Professor-plum/Bsides-SLC-2021/README.md

# Bsides-SLC-2021
Bsides SLC 2021 Badge repository
