Professor-plum/Bsides-SLC-2021/hardware/BSidesSLC2021/BSidesSLC2021.html

# /Users/waylongrange/Documents/BSidesSLC2021/BSidesSLC2021.sch

Tuesday, September 07, 2021 at 08:30:32 AM

Eeschema (5.1.10-1-10_14)

Component Count:44

Ref | Qnty | Value | Part | Datasheet | Description | Vendor
BT1 | 1 | Battery_Cell | Device:Battery_Cell | ~ | Single-cell battery
C1, C2, C7, C8, C9 | 5 | 1uf | Device:C | ~ | Unpolarized capacitor
C3, C4, C5 | 3 | .1uf | Device:C | ~ | Unpolarized capacitor
C6 | 1 | 10uf | Device:C | ~ | Unpolarized capacitor
C10 | 1 | 4.7uf | Device:C | ~ | Unpolarized capacitor
C11 | 1 | 2.2uf | Device:C | ~ | Unpolarized capacitor
D1, D2, D3, D4, D5, D6, D7, D8, D9, D10, D11, D12 | 12 | LED | Device:LED | ~ | Light emitting diode
D13 | 1 | LD271 | LED:LD271 | http://www.alliedelec.com/m/d/40788c34903a719969df15f1fbea1056.pdf | 940nm IR-LED, 5mm
J1 | 1 | Conn_PIC_ICSP_ICD | Connector:Conn_PIC_ICSP_ICD | http://ww1.microchip.com/downloads/en/devicedoc/30277d.pdf | Microchip PIC In-Circuit Serial Programming/Debugging (ICSP/ICD) connector
JP1 | 1 | Jumper_2_Open | Jumper:Jumper_2_Open | ~ | Jumper, 2-pole, open
R1 | 1 | 5K | Device:R_US | ~ | Resistor, US symbol
R2, R3, R6 | 3 | 10K | Device:R_US | ~ | Resistor, US symbol
R4, R7 | 2 | 910K | Device:R_US | ~ | Resistor, US symbol
R5 | 1 | 1K | Device:R_US | ~ | Resistor, US symbol
RV1, RV2 | 2 | R_POT_US | Device:R_POT_US | ~ | Potentiometer, US symbol
SW1, SW2 | 2 | SW_Push | Switch:SW_Push | ~ | Push button switch, generic, two pins
U1 | 1 | MC3419 | Kicad_Grange:MC3419
U2 | 1 | LP5012 | Kicad_Grange:LP5012
U3 | 1 | PIC16LF18346-xGZ | MCU_Microchip_PIC16:PIC16LF18346-xGZ | https://ww1.microchip.com/downloads/en/DeviceDoc/40001839E.pdf | 28KB FLASH, 2KB SRAM, 256B EEPROM, QFN-20
U4 | 1 | TSOP17xx | Interface_Optical:TSOP17xx | http://www.micropik.com/PDF/tsop17xx.pdf | Photo Modules for PCM Remote Control Systems
U5 | 1 | 74LVC1G00 | 74xGxx:74LVC1G00 | http://www.ti.com/lit/sg/scyt129e/scyt129e.pdf | Single NAND Gate, Low-Voltage CMOS
U6 | 1 | OLED_128x64 | Kicad_Grange:OLED_128x64
