Professor-plum/Bsides-SLC-2021/hardware/BSidesSLC2021/BSidesSLC2021.xlsx

BSidesSLC2021
Reference | Quantity | Value | Footprint | Datasheet | MANUFACTURER | PARTNUMBER | MAXIMUM_PACKAGE_HEIGHT | PARTREV | STANDARD
BT1 | 1 | Battery_Cell | Battery:BatteryHolder_Keystone_3034_1x20mm | https://www.mouser.com/datasheet/2/215/3034-743109.pdf | Keystone | 3034
C10 | 1 | 2.2uf | Capacitor_SMD:C_0603_1608Metric_Pad1.08x0.95mm_HandSolder | ~ | Taiyo Yuden | JMK107BJ225KAHT
C11 | 1 | 4.7uf | Capacitor_SMD:C_0603_1608Metric_Pad1.08x0.95mm_HandSolder | ~ | Samsung | CL10A475KP8NNNC
C3 C4 C5 | 3 | .1uf | Capacitor_SMD:C_0603_1608Metric_Pad1.08x0.95mm_HandSolder | ~ | TDK | C0603X6S0J104K030BC
C6 | 1 | 10uf | Capacitor_SMD:C_0603_1608Metric_Pad1.08x0.95mm_HandSolder | ~ | Samsung | CL10A106KQ8NNNC
C1 C2 C7 C8 C9 | 5 | 1uf | Capacitor_SMD:C_0603_1608Metric_Pad1.08x0.95mm_HandSolder | ~ | Kemet | C0603C105K9PACTU
D1 D2 D3 D4 D5 D6 D7 D8 D9 D10 D11 D12 | 12 | White | LED_SMD:LED_0603_1608Metric | ~ | Inolux | IN-S63AT5UW
D13 | 1 | VSMB10940 | DIO_VSMB10940 | https://www.mouser.com/datasheet/2/427/VISH_S_A0001109401_1-2566942.pdf | VISHAY | VSMB10940 | 1.00mm | 1.1 | Manufacturer Recommendations
R1 | 1 | 10K | Resistor_SMD:R_0603_1608Metric | ~ | Yageo | AC0603FR-0710KL
R2 R3 R6 | 3 | 4.7K | Resistor_SMD:R_0603_1608Metric | ~ | VISHAY | CRCW06034K70JNEAC
R5 | 1 | 1K | Resistor_SMD:R_0603_1608Metric | ~ | Yageo | RC0603FR-071KL
R4 R7 | 2 | 910K | Resistor_SMD:R_0603_1608Metric | ~ | Yageo | RC0603FR-07910KL
RV1 RV2 | 2 | R_POT_US | Potentiometer_THT:Potentiometer_Bourns_PTV09A-1_Single_Vertical | https://www.mouser.com/datasheet/2/54/ptv09-777818.pdf | Bourns | PTV09A-4015U-B503
SW1 SW2 | 2 | SW_Push | Button_Switch_SMD:SW_SPST_PTS645 | https://www.mouser.com/datasheet/2/60/pts645-1841767.pdf | C&K | PTS645SK50SMTR92LFS
U1 | 1 | MC3419 | Package_LGA:LGA-12_2x2mm_P0.5mm | https://www.mouser.com/datasheet/2/821/MEMSIC_MC3419_Datasheet-1889799.pdf | MEMSIC | MC3419
U2 | 1 | LP5012 | Package_SO:TSSOP-24_4.4x7.8mm_P0.65mm | https://www.ti.com/lit/gpn/lp5012 | TI | LP5012
U3 | 1 | PIC16LF18346-xGZ | Package_SO:SSOP-20_5.3x7.2mm_P0.65mm | https://ww1.microchip.com/downloads/en/DeviceDoc/40001839E.pdf | Microchip | PIC16LF18346-I/SS
U4 | 1 | TSOP39xx | Grange:TSOP392TR1 | https://www.vishay.com/docs/82788/tsop392tr1.pdf | VISHAY | TSOP39438TR1
U5 | 1 | 74LVC1G00 | Package_TO_SOT_SMD:SOT-353_SC-70-5 | https://www.diodes.com/assets/Datasheets/74LVC1G00.pdf | Diodes Incorporated | 74LVC1G00SE-7
U6 | 1 | OLED_128x64 Blue & Yellow | Grange:SSD1306_ribbon | https://www.vishay.com/docs/37902/oled128o064dbpp3n00000.pdf |  | https://www.alibaba.com/product-detail/0-96-Oled-0-96-Small_1600229512123.html
