Professor-plum/Bsides-SLC-2021/hardware/BSidesSLC2021/BSidesSLC2021.pdf

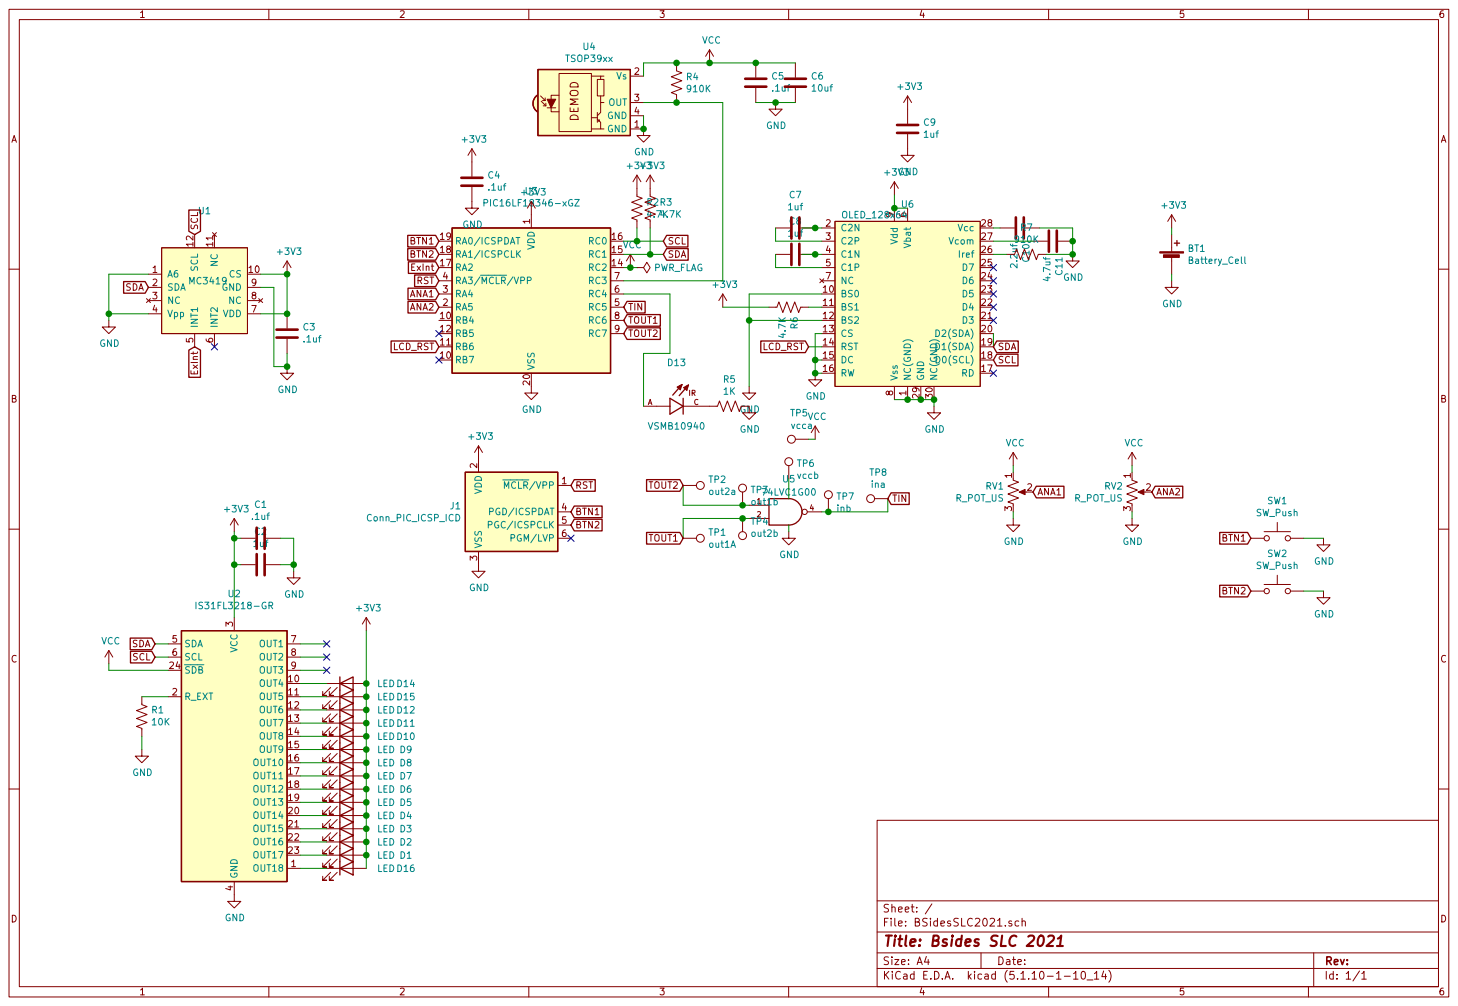
[picture p1: page 1]

1 RB4 10 RB7 10 RB6 11 RB5 12 RC2 14 RC1 15 RC0 16 RA2 17 RA1/ICSPCLK 18 RA0/ICSPDAT 19 RA5 2 VSS 20 RA4 3 RA3/MCLR/VPP 4 RC5 5 RC4 6 RC3 7 RC6 8 RC7 9 U3 PIC16LF18346-xGZ

6 VDD 7 NC 8 GND 9 U1 MC3419 GND

3 RV2 R_POT_US SW1 SW_Push SW2 SW_Push NC(GND) 1 BS0 10 BS1 11 BS2 12 CS 13 RST 14 DC 15 RW 16 RD 17 D0(SCL) 18 D1(SDA) 19 C2N 2 D2(SDA) 20 D3 21 D4 22 D5 23 D6 24 D7 25

File: BSidesSLC2021.sch Sheet: / VDD

3 PGD/ICSPDAT 4 PGC/ICSPCLK 5 PGM/LVP 6

Id: 1/1 Title: Bsides SLC 2021
