Professor-plum/Bsides-SLC-2021/hardware/BSidesSLC2021/BSidesSLC2021.kicad_pcb

## KiCad design hardware/BSidesSLC2021/BSidesSLC2021.kicad_pcb (2021-11-02)

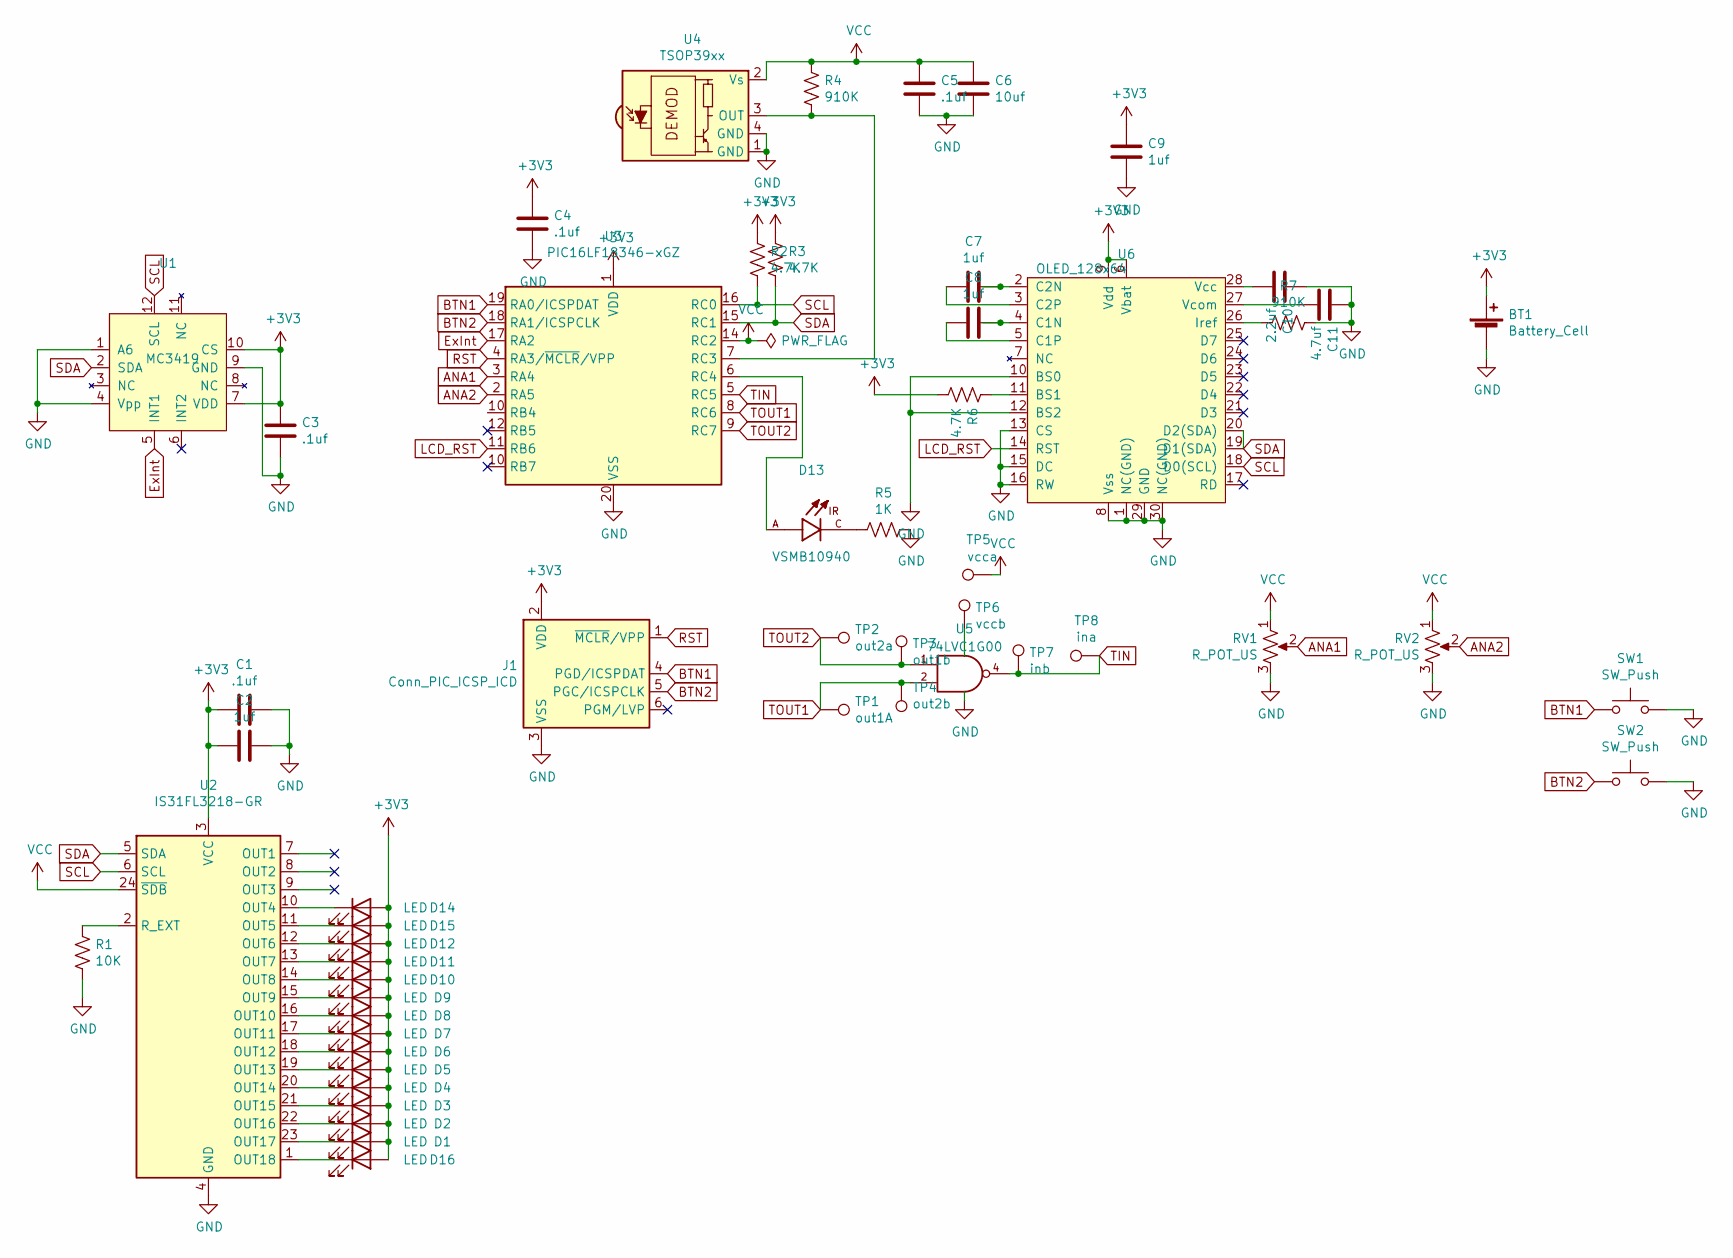
[picture p2: schematic BSidesSLC2021.sch, Bsides SLC 2021]

Parts:
BT1: Battery_Cell; BatteryHolder_Keystone_3034_1x20mm
C1, C3, C4, C5: .1uf; C_0603_1608Metric_Pad1.08x0.95mm_HandSolder
C2, C7, C8, C9: 1uf; C_0603_1608Metric_Pad1.08x0.95mm_HandSolder
C6: 10uf; C_0603_1608Metric_Pad1.08x0.95mm_HandSolder
C10: 2.2uf; C_0603_1608Metric_Pad1.08x0.95mm_HandSolder
C11: 4.7uf; C_0603_1608Metric_Pad1.08x0.95mm_HandSolder
D1, D2, D3, D4, D5, D6, D7, D8, D9, D10, D11, D12, D14, D15, D16: LED; LED_0603_1608Metric
D13: VSMB10940; DIO_VSMB10940; PARTREV 1.1
J1: Conn_PIC_ICSP_ICD; Batt_Conn5
R1: 10K; R_0603_1608Metric
R2, R3, R6: 4.7K; R_0603_1608Metric
R4, R7: 910K; R_0603_1608Metric
R5: 1K; R_0603_1608Metric
RV1, RV2: R_POT_US; Potentiometer_Bourns_PTV09A-1_Single_Vertical
SW1, SW2: SW_Push; SW_SPST_PTS645
TP1: out1A; TestPoint_Pad_D1.0mm
TP2: out2a; TestPoint_Pad_D1.0mm
TP3: out1b; TestPoint_Pad_D1.0mm
TP4: out2b; TestPoint_Pad_D1.0mm
TP5: vcca; TestPoint_Pad_D1.0mm
TP6: vccb; TestPoint_Pad_D1.0mm
TP7: inb; TestPoint_Pad_D1.0mm
TP8: ina; TestPoint_Pad_D1.0mm
U1: MC3419; LGA-12_2x2mm_P0.5mm
U2: IS31FL3218-GR; SOP-24_7.5x15.4mm_P1.27mm
U3: PIC16LF18346-xGZ; SSOP-20_5.3x7.2mm_P0.65mm
U4: TSOP39xx; TSOP392TR1
U5: 74LVC1G00; SOT-353_SC-70-5
U6: OLED_128x64; SSD1306_ribbon

Connections:
+3V3: BT1.1 (+), C1.1, C2.2, C3.2, C4.2, C9.2, D1.2 (A), D2.2 (A), D3.2 (A), D4.2 (A), D5.2 (A), D6.2 (A), D7.2 (A), D8.2 (A), D9.2 (A), D10.2 (A), D11.2 (A), D12.2 (A), D14.2 (A), D15.2 (A), D16.2 (A), J1.2 (VDD), R2.1, R3.1, R6.2, U1.7 (VDD), U1.10 (CS), U2.3 (VCC), U3.1 (VDD), U6.6 (Vbat), U6.9 (Vdd)
ANA1: RV1.2, U3.3 (RA4)
ANA2: RV2.2, U3.2 (RA5)
BTN1: J1.4 (PGD/ICSPDAT), SW1.1, U3.19 (RA0/ICSPDAT)
BTN2: J1.5 (PGC/ICSPCLK), SW2.1, U3.18 (RA1/ICSPCLK)
ExInt: U1.5 (INT1), U3.17 (RA2)
GND: BT1.2 (-), C1.2, C2.1, C3.1, C4.1, C5.1, C6.1, C9.1, C10.2, C11.2, J1.3 (VSS), R1.1, R5.1, R7.1, RV1.3, RV2.3, SW1.2, SW2.2, U1.1 (A6), U1.4 (Vpp), U1.9 (GND), U2.4 (GND), U3.20 (VSS), U4.1 (GND), U4.4 (GND), U5.3 (GND), U6.1 (NC(GND)), U6.8 (Vss), U6.10 (BS0), U6.12 (BS2), U6.13 (CS), U6.15 (DC), U6.16 (RW), U6.29 (GND), U6.30 (NC(GND))
LCD_RST: U3.11 (RB6), U6.14 (RST)
unnamed: C7.1, U6.2 (C2N)
unnamed: C7.2, U6.3 (C2P)
unnamed: C8.1, U6.4 (C1N)
unnamed: C8.2, U6.5 (C1P)
unnamed: C10.1, U6.28 (Vcc)
unnamed: C11.1, U6.27 (Vcom)
unnamed: D1.1 (K), U2.23 (OUT17)
unnamed: D2.1 (K), U2.22 (OUT16)
unnamed: D3.1 (K), U2.21 (OUT15)
unnamed: D4.1 (K), U2.20 (OUT14)
unnamed: D5.1 (K), U2.19 (OUT13)
unnamed: D6.1 (K), U2.18 (OUT12)
unnamed: D7.1 (K), U2.17 (OUT11)
unnamed: D8.1 (K), U2.16 (OUT10)
unnamed: D9.1 (K), U2.15 (OUT9)
unnamed: D10.1 (K), U2.14 (OUT8)
unnamed: D11.1 (K), U2.13 (OUT7)
unnamed: D12.1 (K), U2.12 (OUT6)
unnamed: D13.A, U3.6 (RC4)
unnamed: D13.C, R5.2
unnamed: D14.1 (K), U2.10 (OUT4)
unnamed: D15.1 (K), U2.11 (OUT5)
unnamed: D16.1 (K), U2.1 (OUT18)
unnamed: R1.2, U2.2 (R_EXT)
unnamed: R4.2, U3.7 (RC3), U4.3 (OUT)
unnamed: R6.1, U6.11 (BS1)
unnamed: R7.2, U6.26 (Iref)
RST: J1.1 (~MCLR~/VPP), U3.4 (RA3/~MCLR~/VPP)
SCL: R2.2, U1.12 (SCL), U2.6 (SCL), U3.16 (RC0), U6.18 (D0(SCL))
SDA: R3.2, U1.2 (SDA), U2.5 (SDA), U3.15 (RC1), U6.19 (D1(SDA)), U6.20 (D2(SDA))
TIN: TP7.1, TP8.1, U3.5 (RC5), U5.4
TOUT1: TP1.1, TP4.1, U3.8 (RC6), U5.2
TOUT2: TP2.1, TP3.1, U3.9 (RC7), U5.1

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
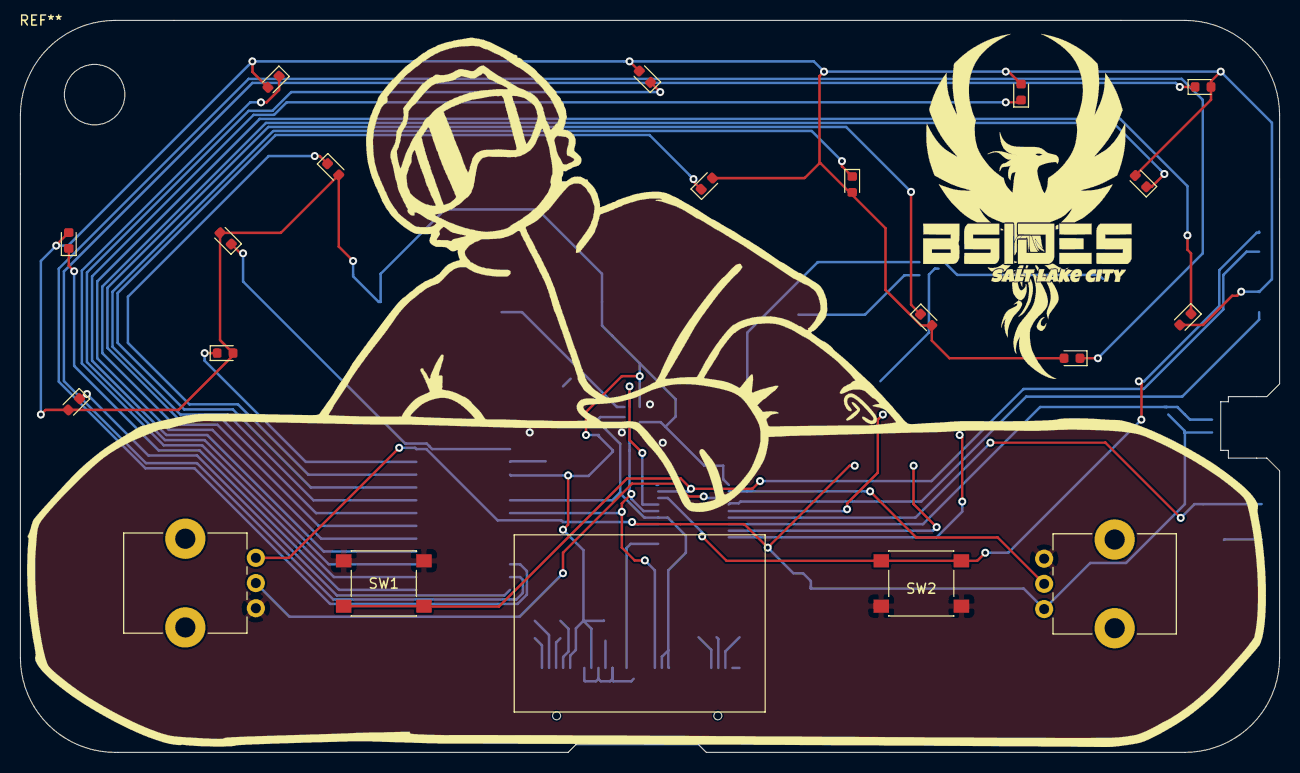
[picture p3: board BSidesSLC2021.kicad_pcb from above]

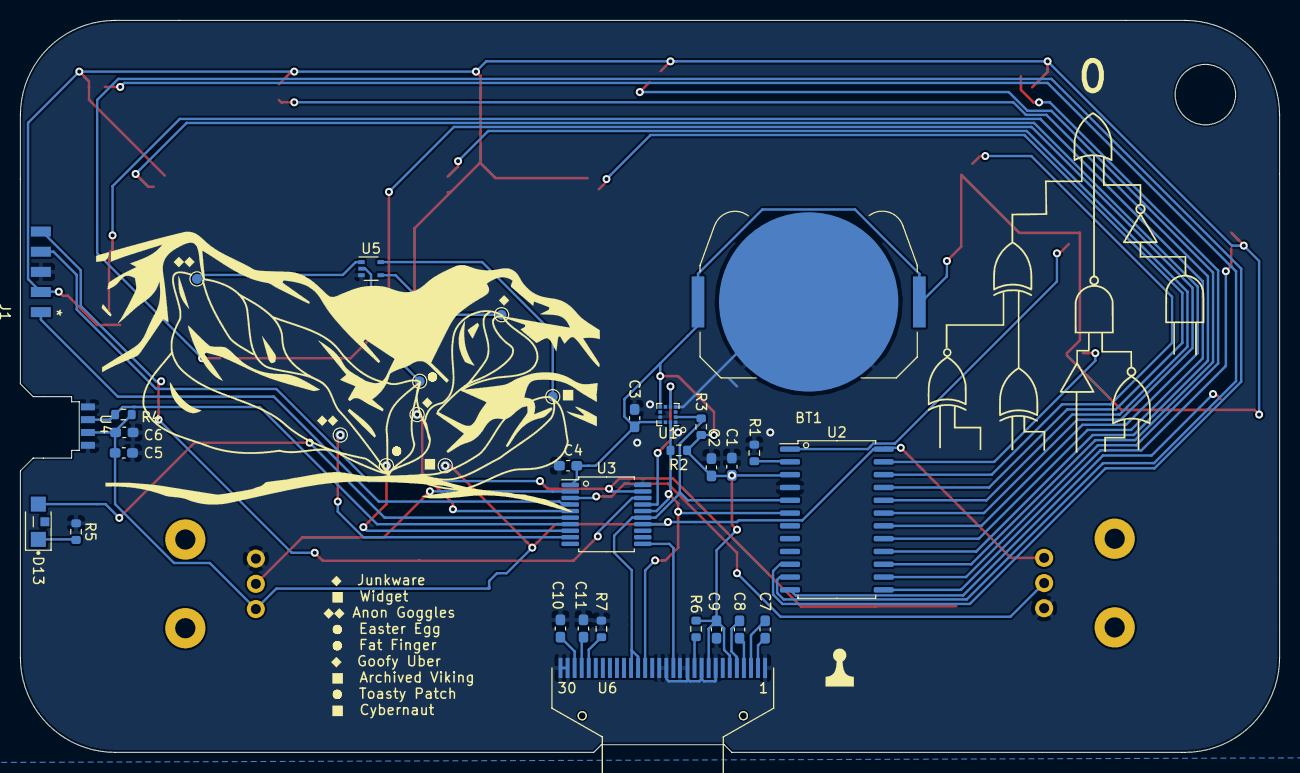
[picture p4: board BSidesSLC2021.kicad_pcb from below]

Board: 2 copper layers, 125.0 x 72.6 mm, 59 parts (38 on the bottom side), 42 nets.

Other parts of the board:
Ref**: Val**; logo_pheonix
Ref**#2: Val**; tree
Ref**#3: Val**; mtn2
Ref**#4: Val**; boarder
Ref**#5: Val**; plum
