Professor-plum/Bsides-SLC-2021/firmware/BSidesSLC2021.X/resources.h

/* 
 * File:   numbers.h
 * Author: plum
 *
 * Created on October 9, 2021, 2:56 PM
 */

#ifndef NUMBERS_H
#define	NUMBERS_H

#ifdef	__cplusplus
extern "C" {
#endif

#pragma pack(1) 
const uint8_t sine_tbl[512] = {
    0x18,0x18,0x18,0x18,0x19,0x19,0x19,0x1a,0x1a,0x1a,0x1a,0x1b,0x1b,0x1b,0x1c,0x1c,0x1c,0x1c,0x1d,0x1d,0x1d,0x1d,0x1e,0x1e,0x1e,0x1f,0x1f,0x1f,0x1f,0x20,0x20,0x20,
    0x20,0x21,0x21,0x21,0x22,0x22,0x22,0x22,0x23,0x23,0x23,0x23,0x24,0x24,0x24,0x24,0x25,0x25,0x25,0x25,0x25,0x26,0x26,0x26,0x26,0x27,0x27,0x27,0x27,0x27,0x28,0x28,
    0x28,0x28,0x29,0x29,0x29,0x29,0x29,0x29,0x2a,0x2a,0x2a,0x2a,0x2a,0x2b,0x2b,0x2b,0x2b,0x2b,0x2b,0x2c,0x2c,0x2c,0x2c,0x2c,0x2c,0x2c,0x2c,0x2d,0x2d,0x2d,0x2d,0x2d,
    0x2d,0x2d,0x2d,0x2e,0x2e,0x2e,0x2e,0x2e,0x2e,0x2e,0x2e,0x2e,0x2e,0x2e,0x2e,0x2e,0x2f,0x2f,0x2f,0x2f,0x2f,0x2f,0x2f,0x2f,0x2f,0x2f,0x2f,0x2f,0x2f,0x2f,0x2f,0x2f,
    0x2f,0x2f,0x2f,0x2f,0x2f,0x2f,0x2f,0x2f,0x2f,0x2f,0x2f,0x2f,0x2f,0x2f,0x2f,0x2f,0x2f,0x2e,0x2e,0x2e,0x2e,0x2e,0x2e,0x2e,0x2e,0x2e,0x2e,0x2e,0x2e,0x2e,0x2d,0x2d,
    0x2d,0x2d,0x2d,0x2d,0x2d,0x2d,0x2c,0x2c,0x2c,0x2c,0x2c,0x2c,0x2c,0x2c,0x2b,0x2b,0x2b,0x2b,0x2b,0x2b,0x2a,0x2a,0x2a,0x2a,0x2a,0x29,0x29,0x29,0x29,0x29,0x29,0x28,
    0x28,0x28,0x28,0x27,0x27,0x27,0x27,0x27,0x26,0x26,0x26,0x26,0x25,0x25,0x25,0x25,0x25,0x24,0x24,0x24,0x24,0x23,0x23,0x23,0x23,0x22,0x22,0x22,0x22,0x21,0x21,0x21,
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
        0xfd, 0xfd, 0xfd, 0xff, 0xfd, 0xfd, 0xfd, 0xfd, 0xfd, 0xfd, 0xfd, 0xfd, 0xff, 0xfd, 0xff, 0x7c, 0x38, 0x0,
    },
};

#pragma pack() 
#ifdef	__cplusplus
}
#endif

#endif	/* NUMBERS_H */
